kandrzejewski/Arduino-simple-weather-station/README.md

# Arduino-simple-weather-station
Aby uruchomić projekt na własnym urządzeniu najpierw należy dodać do projektu biblioteki, które znajdują się w folderze lib
